Capstone46/Arduino/README.md

# Group 46

UBC 2015 EECE Capstone Group 46 - Fall Datalogger

- FallDataAnalyser contains an excel script for processing the recorded data

- Proto2_SLOWSD contains the Arduino source for the device Firmware

- SetRTC contains the Arduino source for a program to set the RTC time with Arduino IDE Serial communication
