Capstone46/Arduino/Deliverables/Hardware/BOM.xlsx

Part | Distributor | Distributor P/N | Quantity | Descriptor | Breakpoints
Enclosure | OKW | B9006827 | 1 | n/a | ?
Enclosure Ring Thing | OKW | B9006757 | 1 | n/a | ?
Velcro Strap | not decided | - | 1 | n/a | -
Microprocessor | Digikey | ATMEGA328P-AU-ND | 1 | U1 | 1,10,25
RTC | Digikey | DS3234SN#-ND | 1 | U2 | 1,10,25
Accelerometer | Digikey | ADXL345BCCZ-ND | 1 | U3 | 1,10,100
Inverter | Digikey | NC7SU04M5XCT-ND | 1 | U4 | 1,10,25
Altimeter | Digikey | MPL3115A2-ND | 1 | U5 | 1,10,25
Crystal | Digikey | 490-1195-1-ND | 1 | X1 | 1,10,50
Green LED | Digikey | 754-1357-1-ND | 1 | LED | 1,10,25
Red LED | Digikey | 754-1359-1-ND | 1 | ERR | 1,10,25
microSD connector | Digikey | 101-00660-68-6-1-ND | 1 | J1 | 1,10,25,50
Power Switch | Digikey | 401-2001-ND | 1 | PWR | 1,10,50
Button | Digikey | CKN10244CT-ND | 2 | RST, REC | 1,10,25,50
12.5mm Batt. Holder | Digikey | BK-885-ND | 1 | BH1 | 1,10
Main Batt. Holder | Digikey | BH1000G-ND | 1 | BH2 | 1,10
10K Resistor | Digikey | MCT0603-10.0K-CFCT-ND | 2 | R1,R5 | 1,10,50
300R Resistor | Digikey | 1276-5518-1-ND | 2 | R3,R4 | 1,10,25
Jumper | Digikey | P0.0ACT-ND | 1 | R6 | 1,50
1K Resistor | Digikey | MCT0603-1.00K-CFCT-ND+ | 2 | R7,R8 | 1,10,50
10uF Capacitor | Digikey | 511-1683-1-ND | 2 | C1,C10 | 1,10,25
0.1uF Capacitor | Digikey | 490-1524-1-ND | 7 | C2,C3,C4,C6,C7,C9,C11 | 1,50,100
22pF Capacitor | Digikey | 490-9662-1-ND | 1 | C5 | 1,10,50
1uF Capacitor | Digikey | 490-3897-1-ND | 1 | C8 | 1,10,50
12.5mm Battery | Digikey | SY033-ND | 1 | n/a | 1,10,50
24.5mm Battery | Digikey | P120-ND | 1 | n/a | 1,10,50
8Gb microSD card | Amazon? | - | 1 | n/a | ?
PCB | Omnicircuit | custom | 1 | n/a | 5,18,36
