Capstone46/Arduino/(commit log)

2015-02-09 Adding Fall Data Analyser
    Uses VBA macro and currently a .CSV input file to analyse data
    [Fall Data Analyser.xlsm]
2015-02-10 Repositioned Command Button
    [Fall Data Analyser.xlsm]
2015-02-13 Testing and Interuppt
    a bunch of stuff there but commented out for testing.
    added stuff for the INT1 to pin D3 interrupt
2015-03-22 Added Mac Support
    -Mac Support
    -Plotting Improvements
    [Fall Data Analyser.xlsm]
2015-03-22 Re-calibrated impact threshold based on PCB1 data
    [Fall Data Analyser.xlsm]
2015-03-31 Update before demo
    [Fall Data Analyser.xlsm]
2015-03-31 Revert "Update before demo"
    This reverts commit dcdf631a83ec682735b54125801c8e14497058b5.
    [Fall Data Analyser.xlsm]
2015-04-08 Added: Sleep Lines, Low Pass filtered Altitude
    [Fall Data Analyser.xlsm]
2015-04-09 Adding in Hardware Deliverables for Prototype 3
    BOM for proto 3, instructions, settings files, PCB and PCBA files
    [BOM.xlsx]
